richardFirth/SelfBalanceRobot/DXF/SelfBalanceRobot_LaserCut.dxf

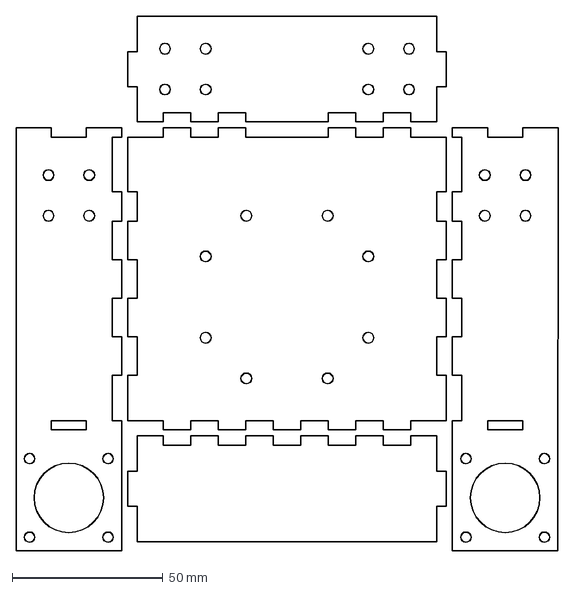
[picture p2: CAD file, 2018-01-28]
DXF/SelfBalanceRobot_LaserCut.dxf
179.5 x 177.0 mm
