richardFirth/SelfBalanceRobot/STL/Stabilizer.stl

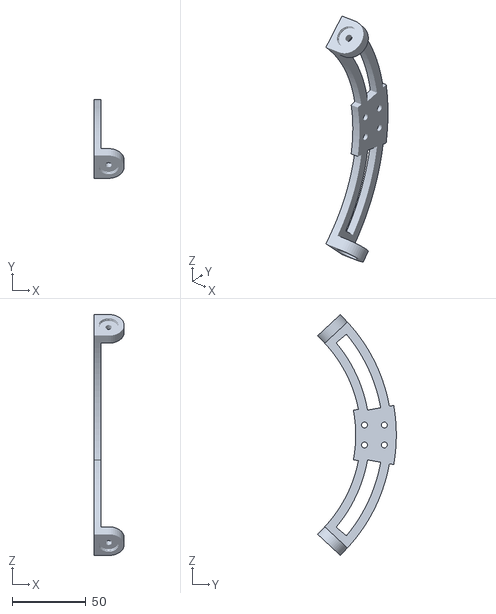
[picture p3: CAD file, 2018-01-26]
STL/Stabilizer.stl
20.5 x 53.2 x 163.0
