richardFirth/SelfBalanceRobot/STL/BatteryHolderB_2.stl

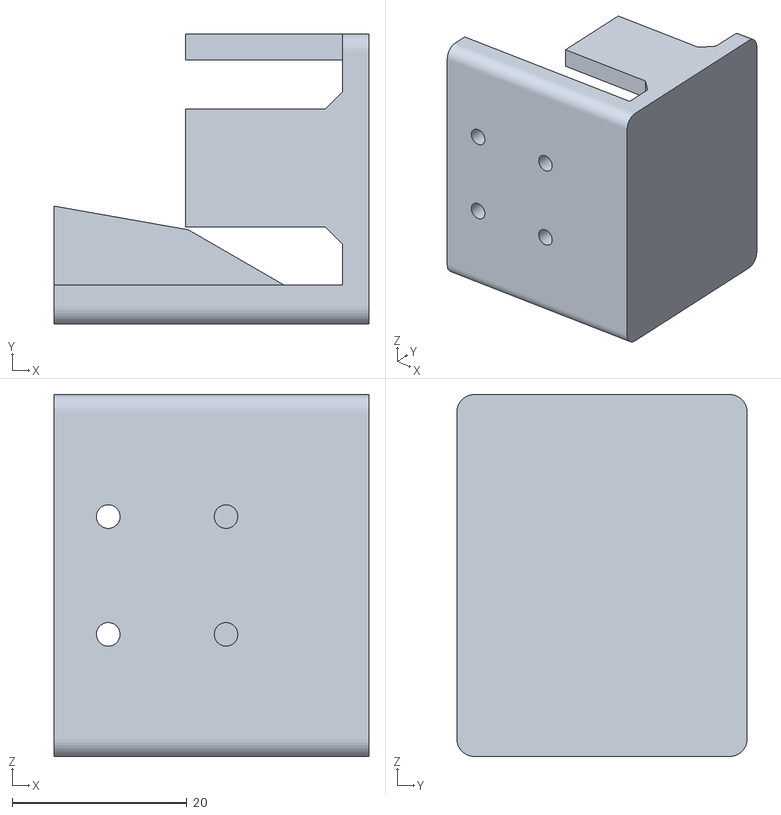
[picture p5: CAD file, 2018-01-26]
STL/BatteryHolderB_2.stl
36.0 x 33.2 x 41.4
