richardFirth/SelfBalanceRobot/STL/3D_Wheel.stl

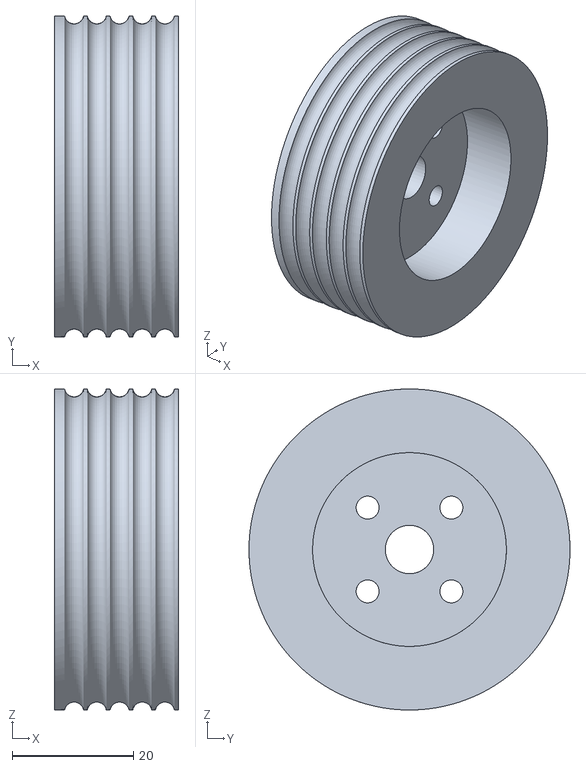
[picture p6: CAD file, 2018-01-26]
STL/3D_Wheel.stl
20.5 x 53.0 x 53.0
