richardFirth/SelfBalanceRobot/Eagle_SelfBalance/SelfBalance_V3.brd

## EAGLE design Eagle_SelfBalance/SelfBalance_V3.brd (2018-01-26)

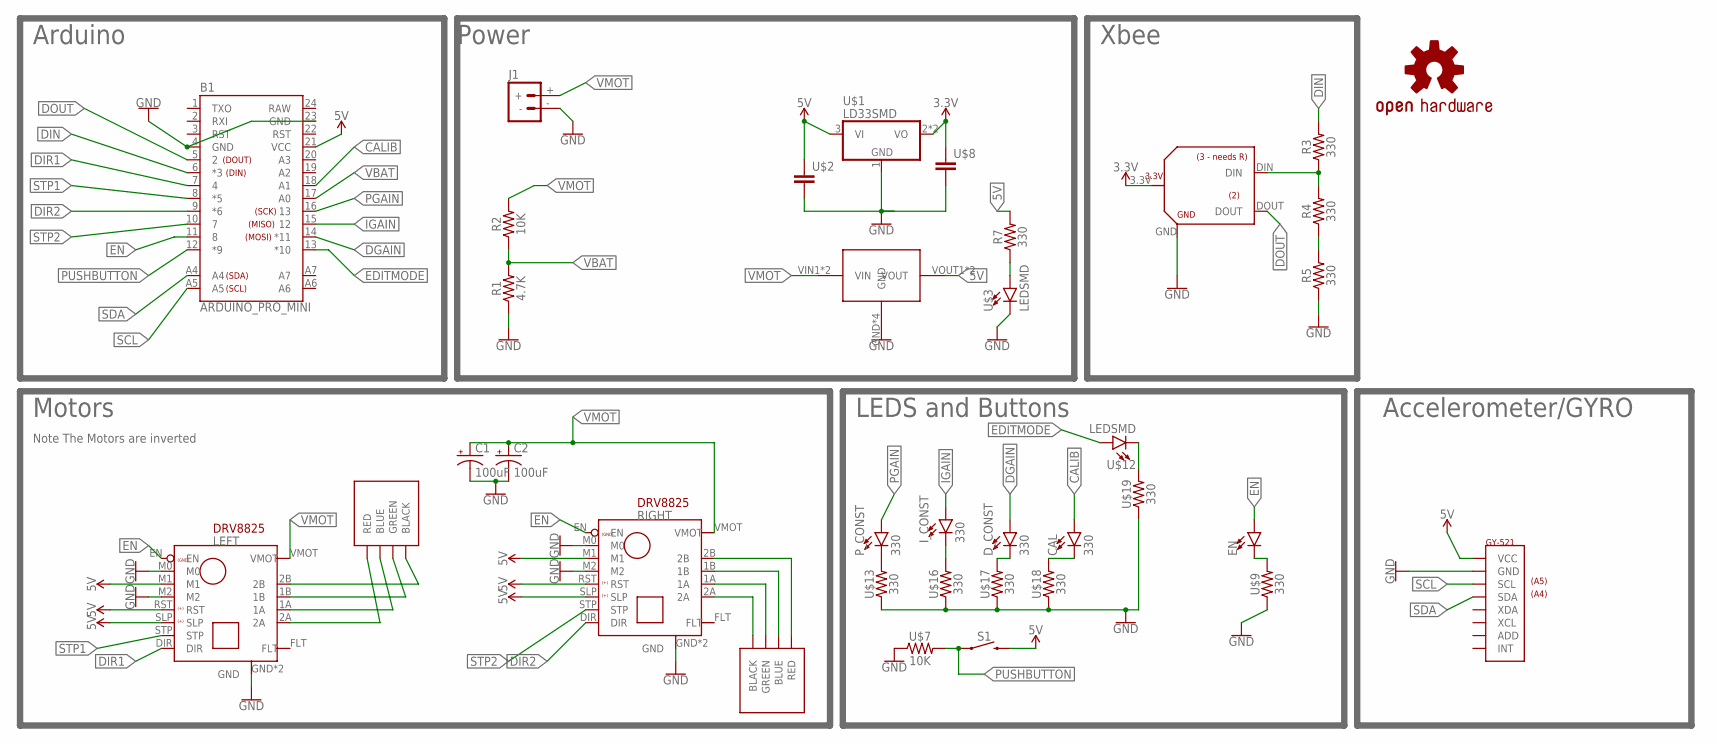
[picture p7: schematic SelfBalance_V3.sch]

Parts:
B1: ARDUINO_PRO_MINI
C1, C2: 100uF; CAP_E
CAL: 330; LED_SMD
D_CONST: 330; LED_SMD
EN: LEDSMD; LED_SMD
I_CONST: 330; LED_SMD
J1: BATTERY_CONNMALE; DEANS_MALE
LEFT: DRV8825
LOGO1: OSHW-LOGOL; OSHW-LOGO-L
P_CONST: 330; LED_SMD
R1: 4.7K; R1206
R2: 10K; R1206
R3, R4, R5, R7: 330; R1206
RIGHT: DRV8825
S1: PUSH_BUTTON6MM; BUTTON_6MM
U$1: LD33SMD; SOT223
U$2, U$8: CAP_SMCAP; C1206
U$3, U$12: LEDSMD; LED_SMD
U$4: STEPDOWNGREEN; STEPDOWN
U$5: GY-521
U$6: XBEE_BOUT
U$7: 10K; R1206
U$9, U$13, U$16, U$17, U$18, U$19: 330; R1206
U$14, U$15: STEPPER; 2X4

Connections:
3.3V: U$1.2 (VO), U$1.4 (VO), U$6.3.3V, U$8.1
5V: B1.21 (VCC), LEFT.M1, LEFT.RST, LEFT.SLP, R7.2, RIGHT.M1, RIGHT.RST, RIGHT.SLP, S1.3 (2), U$1.3 (VI), U$2.1, U$4.VOUT1 (VOUT), U$4.VOUT2 (VOUT), U$5.VCC
CALIB: B1.18 (A1), CAL.A
DGAIN: B1.14 (*11), D_CONST.A
DIN: B1.6 (*3), R3.2
DIR1: B1.7 (4), LEFT.DIR
DIR2: B1.9 (*6), RIGHT.DIR
DOUT: B1.5 (2), U$6.DOUT
EDITMODE: B1.13 (*10), U$12.A
EN: B1.11 (8), EN.A, LEFT.EN, RIGHT.EN
GND: B1.4 (GND), B1.23 (GND), C1.-, C2.-, J1.-, LEFT.GND, LEFT.GND2 (GND), LEFT.M0, LEFT.M2, R1.1, R5.1, RIGHT.GND, RIGHT.GND2 (GND), RIGHT.M0, RIGHT.M2, U$1.1 (GND), U$2.2, U$3.C, U$4.GND, U$4.GND2 (GND), U$4.GND3 (GND), U$4.GND4 (GND), U$5.GND, U$6.GND, U$7.1, U$8.2, U$9.1, U$13.1, U$16.1, U$17.1, U$18.1, U$19.1
IGAIN: B1.15 (12), I_CONST.A
unnamed: P_CONST.C, U$13.2
unnamed: LEFT.2B, U$14.B1 (BLACK), U$14.B2 (BLACK)
unnamed: R7.1, U$3.A
unnamed: I_CONST.C, U$16.2
unnamed: D_CONST.C, U$17.2
unnamed: CAL.C, U$18.2
unnamed: LEFT.1A, U$14.U1 (BLUE), U$14.U2 (BLUE)
unnamed: LEFT.2A, U$14.R1 (RED), U$14.R2 (RED)
unnamed: RIGHT.2B, U$15.R1 (RED), U$15.R2 (RED)
unnamed: RIGHT.1B, U$15.U1 (BLUE), U$15.U2 (BLUE)
unnamed: RIGHT.1A, U$15.G1 (GREEN), U$15.G2 (GREEN)
unnamed: RIGHT.2A, U$15.B1 (BLACK), U$15.B2 (BLACK)
unnamed: R4.1, R5.2
unnamed: R3.1, R4.2, U$6.DIN
unnamed: U$12.C, U$19.2
unnamed: EN.C, U$9.2
unnamed: LEFT.1B, U$14.G1 (GREEN), U$14.G2 (GREEN)
PGAIN: B1.16 (13), P_CONST.A
PUSHBUTTON: B1.12 (*9), S1.1, U$7.2
RAW: B1.24 (RAW)
SCL: B1.A5, U$5.SCL
SDA: B1.A4, U$5.SDA
STP1: B1.8 (*5), LEFT.STP
STP2: B1.10 (7), RIGHT.STP
VBAT: B1.17 (A0), R1.2, R2.1
VMOT: C1.+, C2.+, J1.+, LEFT.VMOT, R2.2, RIGHT.VMOT, U$4.VIN1 (VIN), U$4.VIN2 (VIN)

Notes on the sheet:
LEDS and Buttons
Motors
Arduino
Power
Xbee
Accelerometer/GYRO
Note The Motors are inverted

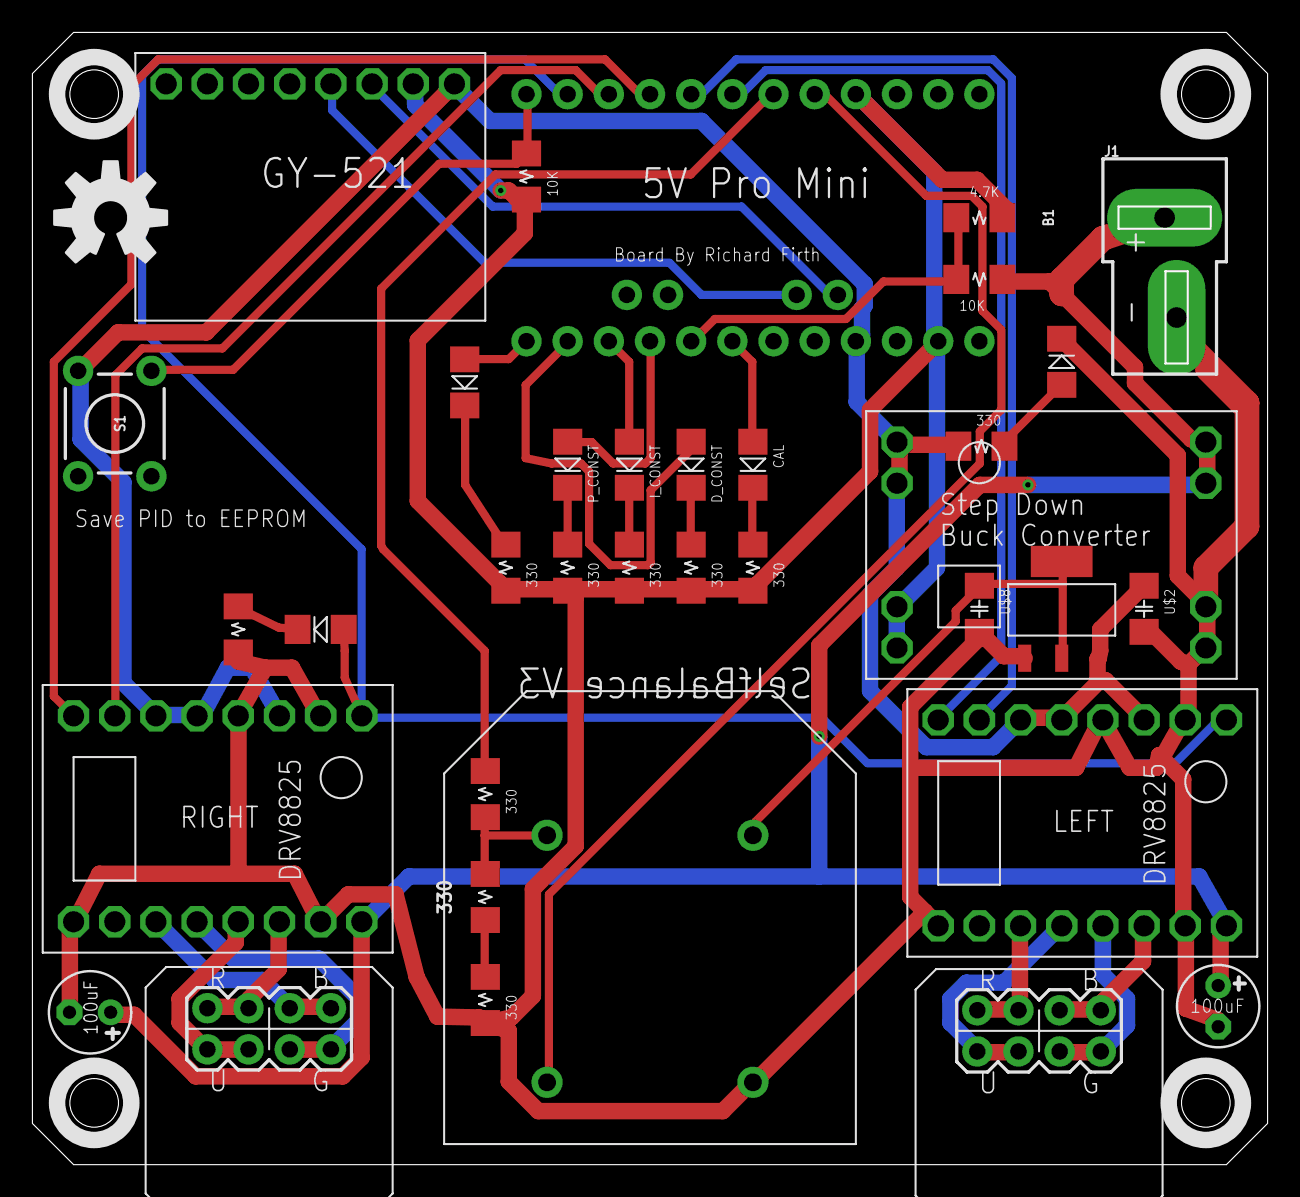
[picture p8: board SelfBalance_V3.brd from above]

Board: 2 copper layers, 76.2 x 69.8 mm, 36 parts (0 on the bottom side), 37 nets.
