richardFirth/SelfBalanceRobot/Eagle_SelfBalance/XBeeBreakOut.brd

## EAGLE design Eagle_SelfBalance/XBeeBreakOut.brd (2018-01-26)

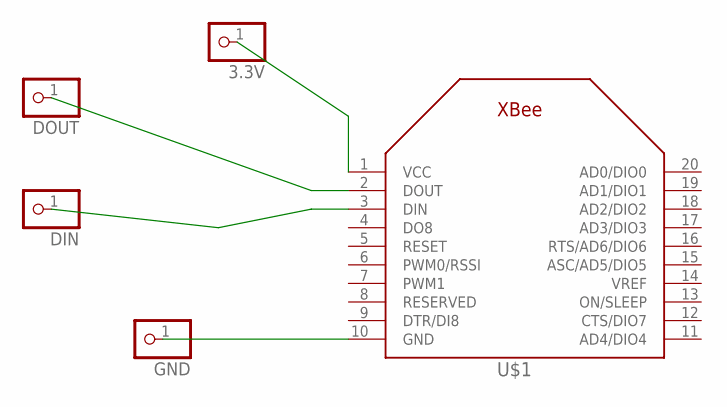
[picture p9: schematic XBeeBreakOut.sch]

Parts:
3.3V: PINHD-1X1; 1X01
DIN: PINHD-1X1; 1X01
DOUT: PINHD-1X1; 1X01
GND: PINHD-1X1; 1X01
U$1: XBEE

Connections:
DIN: DIN.1, U$1.3 (DIN)
DOUT: DOUT.1, U$1.2 (DOUT)
GND: GND.1, U$1.10 (GND)
VCC: 3.3V.1, U$1.1 (VCC)

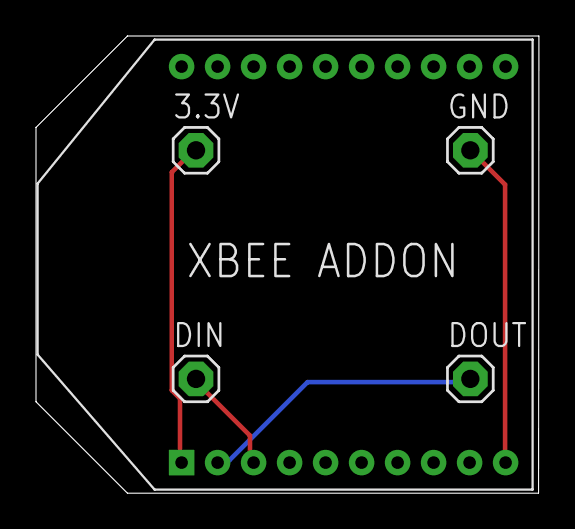
[picture p10: board XBeeBreakOut.brd from above]

Board: 2 copper layers, 27.9 x 25.4 mm, 5 parts (0 on the bottom side), 4 nets.
