richardFirth/SelfBalanceRobot/Balancing_robot_RF/AC_PIDCalc.ino

void PIDCalculations()
{
  ///////////////////////////////////////////////////////////////////////////////////////////////////////////////////////////////////////
  //PID controller calculations
  ///////////////////////////////////////////////////////////////////////////////////////////////////////////////////////////////////////
  //The balancing robot is angle driven. First the difference between the desired angel (setpoint) and actual angle (process value)
  //is calculated. The self_balance_pid_setpoint variable is automatically changed to make sure that the robot stays balanced all the time.
  //The (pid_setpoint - pid_output * 0.015) part functions as a brake function.
  pid_error_temp = angle_gyro - self_balance_pid_setpoint - pid_setpoint;
  if (pid_output > 10 || pid_output < -10)pid_error_temp += pid_output * 0.015 ;

  pid_i_mem += myOperatingValues.pid_i_gain * pid_error_temp;                                 //Calculate the I-controller value and add it to the pid_i_mem variable
  if (pid_i_mem > 400)pid_i_mem = 400;                                      //Limit the I-controller to the maximum controller output
  else if (pid_i_mem < -400)pid_i_mem = -400;
  //Calculate the PID output value
  pid_output = myOperatingValues.pid_p_gain * pid_error_temp + pid_i_mem + myOperatingValues.pid_d_gain * (pid_error_temp - pid_last_d_error);
  if (pid_output > 400)pid_output = 400;                                    //Limit the PI-controller to the maximum controller output
  else if (pid_output < -400)pid_output = -400;

  pid_last_d_error = pid_error_temp;                                        //Store the error for the next loop

  if (pid_output < 5 && pid_output > -5)pid_output = 0;                     //Create a dead-band to stop the motors when the robot is balanced

  if (angle_gyro > 30 || angle_gyro < -30 || !startProg) {                       //If the robot tips over or the start variable is zero or the battery is empty
    pid_output = 0;                                                         //Set the PID controller output to 0 so the motors stop moving
    pid_i_mem = 0;                                                          //Reset the I-controller memory
    startProg = false;                                                      //Set the start variable to 0
    SetAllLEDS(0, 0, 0, 0, 0);
    self_balance_pid_setpoint = 0;                                          //Reset the self_balance_pid_setpoint variable
    digitalWrite(ENABLE, HIGH);
  }

}
