richardFirth/SelfBalanceRobot/Balancing_robot_RF/AE_MotorPulseCalc.ino

///////////////////////////////////////////////////////////////////////////////////////////////////////////////////////////////////////
//Motor pulse calculations
///////////////////////////////////////////////////////////////////////////////////////////////////////////////////////////////////////
//To compensate for the non-linear behaviour of the stepper motors the folowing calculations are needed to get a linear speed behaviour.

void MotorPulseCalc()
{
  if (pid_output_left > 0)pid_output_left = 405 - (1 / (pid_output_left + 9)) * 5500;
  else if (pid_output_left < 0)pid_output_left = -405 - (1 / (pid_output_left - 9)) * 5500;

  if (pid_output_right > 0)pid_output_right = 405 - (1 / (pid_output_right + 9)) * 5500;
  else if (pid_output_right < 0)pid_output_right = -405 - (1 / (pid_output_right - 9)) * 5500;

  //Calculate the needed pulse time for the left and right stepper motor controllers
  if (pid_output_left > 0)left_motor = 400 - pid_output_left;
  else if (pid_output_left < 0)left_motor = -400 - pid_output_left;
  else left_motor = 0;
  if (pid_output_right > 0)right_motor = 400 - pid_output_right;
  else if (pid_output_right < 0)right_motor = -400 - pid_output_right;
  else right_motor = 0;

  //Copy the pulse time to the throttle variables so the interrupt subroutine can use them
  throttle_left_motor = left_motor;
  throttle_right_motor = right_motor;
}
