richardFirth/SelfBalanceRobot/Balancing_robot_RF/AA_Setup.ino

void setPinModes()
{
  pinMode(CALIB_LED, OUTPUT);  //yellow
  pinMode(P_GAIN, OUTPUT);  //blue
  pinMode(I_GAIN, OUTPUT);  //green
  pinMode(D_GAIN, OUTPUT);  //red
  pinMode(EDIT_MODE, OUTPUT);  //red
  pinMode(ENABLE, OUTPUT);  //red
  pinMode(PUSH_BUTTON, INPUT);  //SW1

  pinMode(LEFT_DIR, OUTPUT);  //direction
  pinMode(LEFT_STP, OUTPUT);  //step
  pinMode(RIGHT_DIR, OUTPUT);  //direction
  pinMode(RIGHT_STP, OUTPUT);  //step
}

void setGyroRegisters()
{
  //By default the MPU-6050 sleeps. So we have to wake it up.
  Wire.beginTransmission(gyro_address);                                     //Start communication with the address found during search.
  Wire.write(0x6B);                                                         //We want to write to the PWR_MGMT_1 register (6B hex)
  Wire.write(0x00);                                                         //Set the register bits as 00000000 to activate the gyro
  Wire.endTransmission();                                                   //End the transmission with the gyro.
  //Set the full scale of the gyro to +/- 250 degrees per second
  Wire.beginTransmission(gyro_address);                                     //Start communication with the address found during search.
  Wire.write(0x1B);                                                         //We want to write to the GYRO_CONFIG register (1B hex)
  Wire.write(0x00);                                                         //Set the register bits as 00000000 (250dps full scale)
  Wire.endTransmission();                                                   //End the transmission with the gyro
  //Set the full scale of the accelerometer to +/- 4g.
  Wire.beginTransmission(gyro_address);                                     //Start communication with the address found during search.
  Wire.write(0x1C);                                                         //We want to write to the ACCEL_CONFIG register (1A hex)
  Wire.write(0x08);                                                         //Set the register bits as 00001000 (+/- 4g full scale range)
  Wire.endTransmission();                                                   //End the transmission with the gyro
  //Set some filtering to improve the raw data.
  Wire.beginTransmission(gyro_address);                                     //Start communication with the address found during search
  Wire.write(0x1A);                                                         //We want to write to the CONFIG register (1A hex)
  Wire.write(0x03);                                                         //Set the register bits as 00000011 (Set Digital Low Pass Filter to ~43Hz)
  Wire.endTransmission();                                                   //End the transmission with the gyro
}

void GyroCalibration()
{
  for (int GyroCalibration_counter = 0; GyroCalibration_counter < 500; GyroCalibration_counter++) {     //Create 500 loops
    if (GyroCalibration_counter % 15 == 0)digitalWrite(CALIB_LED, !digitalRead(CALIB_LED));  //Change the state of the LED every 15 loops to make the LED blink fast
    Wire.beginTransmission(gyro_address);                                   //Start communication with the gyro
    Wire.write(0x43);                                                       //Start reading the Who_am_I register 75h
    Wire.endTransmission();                                                 //End the transmission
    Wire.requestFrom(gyro_address, 4);                                      //Request 2 bytes from the gyro
    gyro_yaw_calibration_value += Wire.read() << 8 | Wire.read();           //Combine the two bytes to make one integer
    gyro_pitch_calibration_value += Wire.read() << 8 | Wire.read();         //Combine the two bytes to make one integer
    delayMicroseconds(3700);                                                //Wait for 3700 microseconds to simulate the main program loop time
  }
  gyro_pitch_calibration_value /= 500;                                      //Divide the total value by 500 to get the avarage gyro offset
  gyro_yaw_calibration_value /= 500;                                        //Divide the total value by 500 to get the avarage gyro offset
}

void setupTimer()
{
  //To create a variable pulse for controlling the stepper motors a timer is created that will execute a piece of code (subroutine) every 20us
  //This subroutine is called TIMER2_COMPA_vect
  TCCR2A = 0;                                                               //Make sure that the TCCR2A register is set to zero
  TCCR2B = 0;                                                               //Make sure that the TCCR2A register is set to zero
  TIMSK2 |= (1 << OCIE2A);                                                  //Set the interupt enable bit OCIE2A in the TIMSK2 register
  TCCR2B |= (1 << CS21);                                                    //Set the CS21 bit in the TCCRB register to set the prescaler to 8
  OCR2A = 39;                                                               //The compare register is set to 39 => 20us / (1s / (16.000.000MHz / 8)) - 1
  TCCR2A |= (1 << WGM21);                                                   //Set counter 2 to CTC (clear timer on compare) mode
}
