richardFirth/SelfBalanceRobot/(commit log)

2018-01-26 added eagle files, modified readme
    [SelfBalance_V3.brd, SelfBalance_V3.sch, StepperBoard.brd, StepperBoard.sch, XBeeBreakOut.brd, XBeeBreakOut.sch]
2018-01-26 Add eagle PCB Files
    Eagle PCB files for self balancing robot based on Joops Video.
    [3D_Wheel.stl, BatteryHolderA_2.stl, BatteryHolderB_2.stl, Stabilizer.stl]
2018-01-28 Add DXF, update code to remove redundant functions
    [SelfBalanceRobot_LaserCut.dxf]
